Ved-Bhagat10/ADM-Algorithm-on-6-Stage-Pipelined-RISC-V-CPU/docs/Simulation_waveform.png

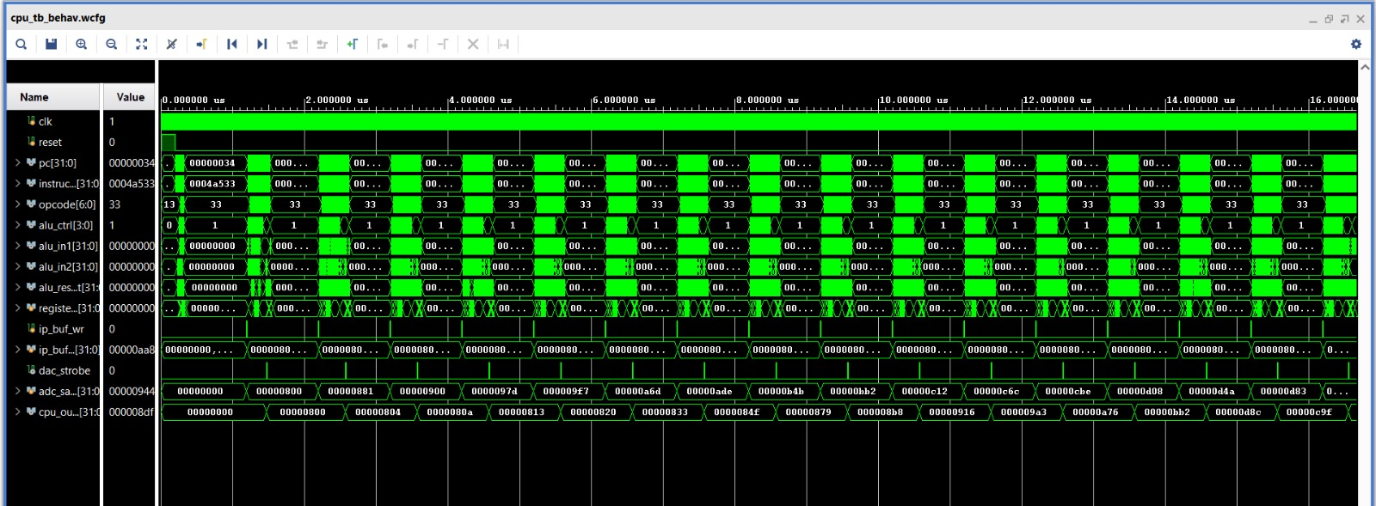
docs/Simulation_waveform.png
