Ved-Bhagat10/ADM-Algorithm-on-6-Stage-Pipelined-RISC-V-CPU/docs/Design_timing_summary.png

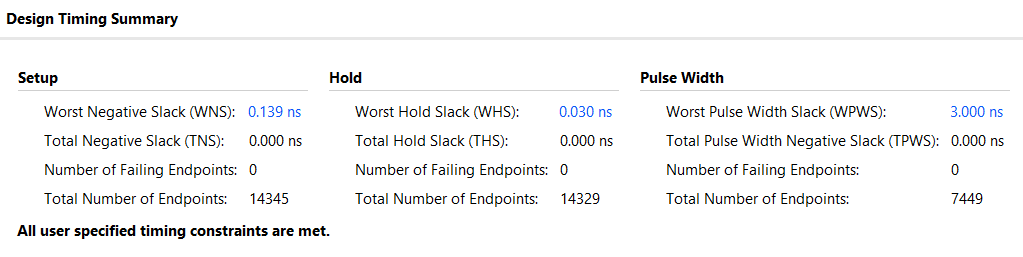
docs/Design_timing_summary.png
