Ved-Bhagat10/ADM-Algorithm-on-6-Stage-Pipelined-RISC-V-CPU/docs/max_delay_paths.png

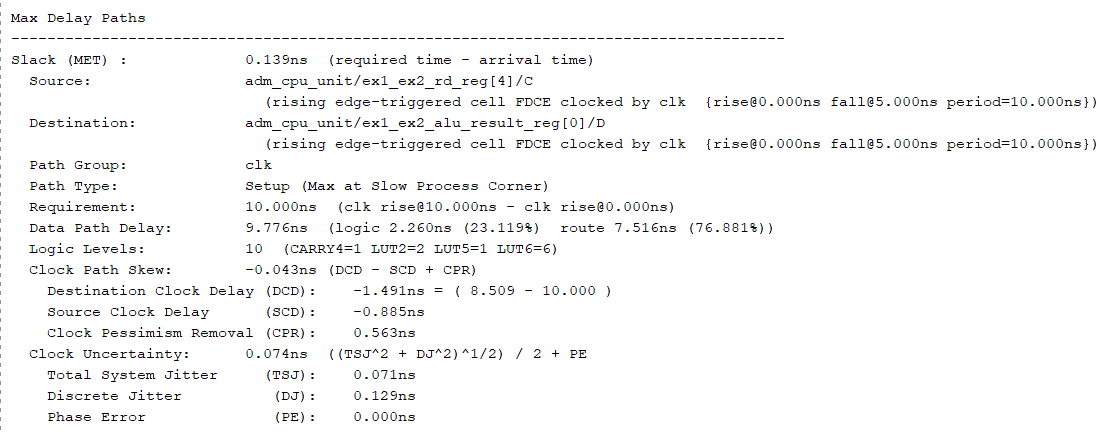
docs/max_delay_paths.png
