Ved-Bhagat10/ADM-Algorithm-on-6-Stage-Pipelined-RISC-V-CPU/docs/output_waveform.jpeg

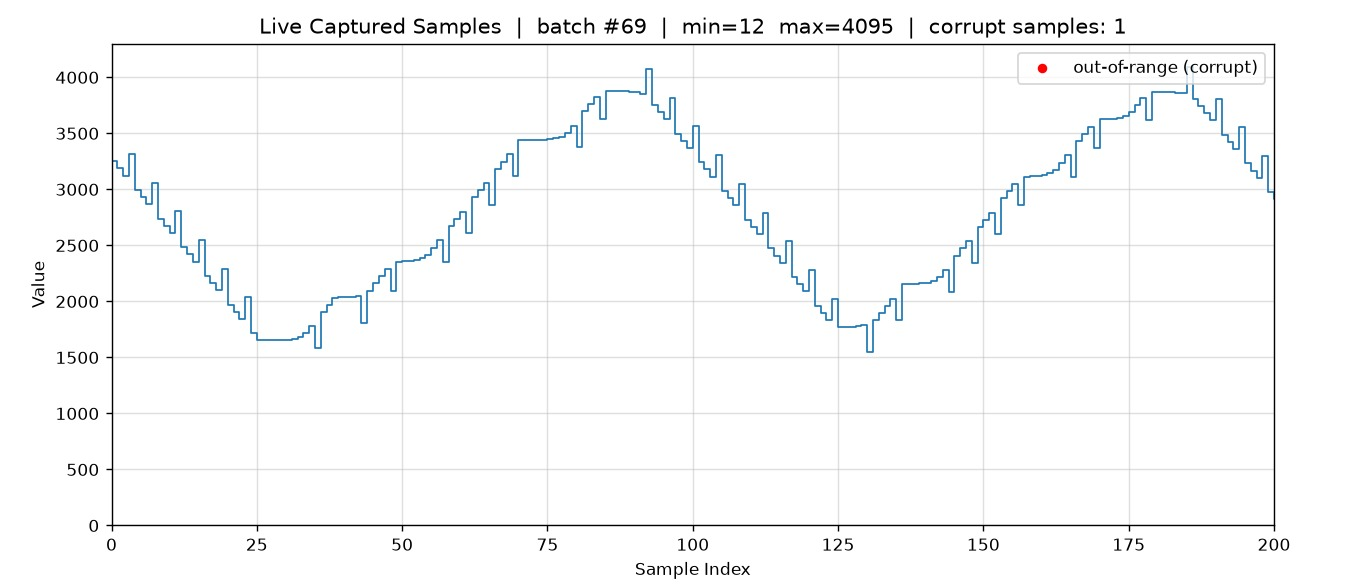
docs/output_waveform.jpeg
