Ved-Bhagat10/ADM-Algorithm-on-6-Stage-Pipelined-RISC-V-CPU/rtl/program_counter.v

module pc(
    input clk, 
    input reset,
    input [31:0] next_pc,
    output reg [31:0] pc
);

always @(posedge clk or posedge reset) begin
    if(reset) begin
        pc<=32'b0;
    end else begin
        pc<=next_pc;
    end
end

endmodule
